black-device/MuteButton/firmware/source code/usb_hid_cdc_lib.X/README.md

# USB Hid-CDC library

Librería para implementar en un único dispositivo un HID de teclado y un puerto serie por USB
