black-device/MuteButton/firmware/source code/win-snd-mngr/btn2_green.png

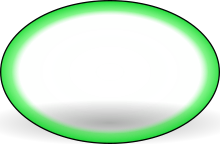
firmware/source code/win-snd-mngr/btn2_green.png
