black-device/MuteButton/firmware/source code/win-snd-mngr/btn_gray2.png

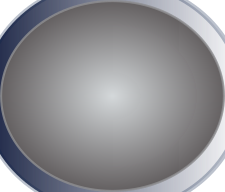
firmware/source code/win-snd-mngr/btn_gray2.png
