black-device/MuteButton/firmware/source code/win-snd-mngr/btn_gray.png

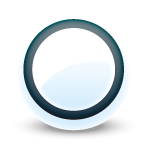
firmware/source code/win-snd-mngr/btn_gray.png
