black-device/MuteButton/images/002-mutebutton-render.jpg

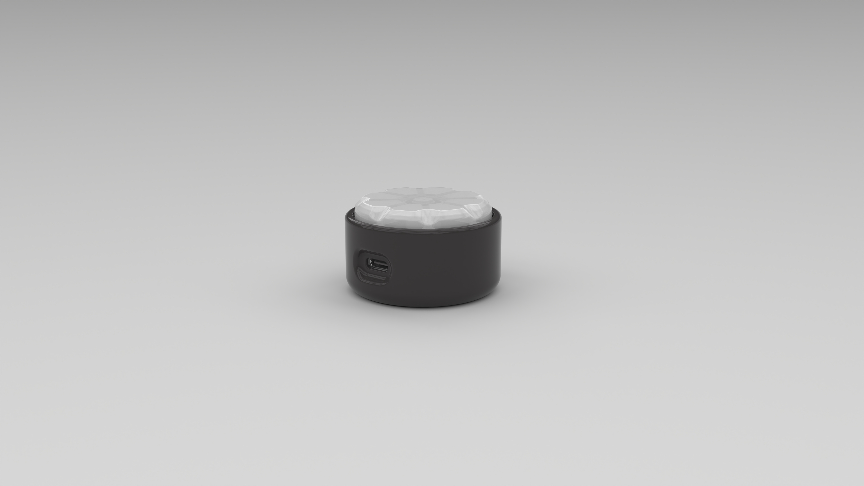
images/002-mutebutton-render.jpg
