black-device/MuteButton/images/mutebutton-exploded-specs.jpg

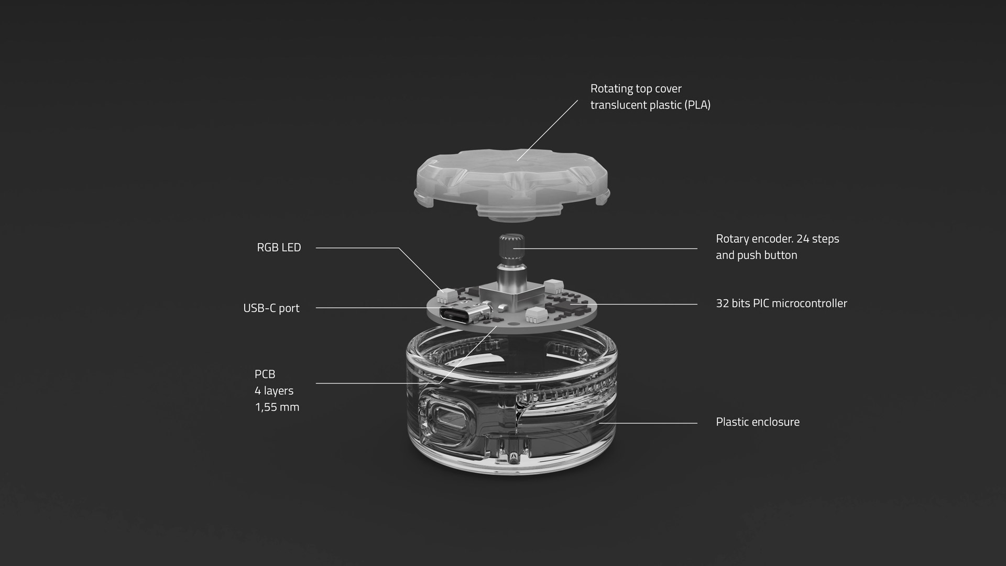
images/mutebutton-exploded-specs.jpg
