black-device/MuteButton/hardware/bom-mutebutton-v1.xlsx

Quantity | Designator | Manufacturer Part Number | Manufacturer | Comment | Description | Footprint
4 | C8, C10, C12, C13 | TMK212BBJ106MG-T | Taiyo Yuden | 10uF 25V | CAP CER 10UF 25V X5R 0805 | CAP 0805/2012 RF
3 | D1, D2, D3 | RF-W7SP30TS-A44 | REFOND | RGB RF-W7SP30TS-A44 | LED RGB PLCC6 3528 RF-W7SP30TS-A44 | LED PLCC6 3528 univ
1 | R4 | RC0603FR-0710KL | Yageo | 10K | RES SMD 10K OHM 1% 1/10W 0603 | RES 0603/1608 RF
2 | R13, R14 | RC0603FR-071KL | Yageo | 1K | RES SMD 1K OHM 1% 1/10W 0603 | RES 0603/1608 RF
1 | U1 | PIC32MM0256GPM048-I/M4 | Microchip | PIC32MM0256GPM048-I/M4 | MCU 32-Bit PIC32MMGP MIPS32 RISC 256KB Flash 2V to 3.6V 48-Pin UQFN Tube PIC32MM0256GPM048-I/M4 | UQFN48_shrink
1 | U2 | LDL1117S33R | STMicroelectronics | LDL1117S33R | IC REG LINEAR 3.3V 1.2A SOT223 | SOT223
3 | R2, R7, R9 | HP03W5F1500T5E | Royal Electronic Factory | 150R | R 0603 150R 100mW 1% HP03W5F1500T5E | RES 0603/1608 RF
1 | J2 | GSB4D313302Y1HR | Amphenol ICC / FCI | GSB4D313302Y1HR | USB4.0 GEN3, Type C, Top Mount, Ch 1.58MM, Dual Row SMT | CON_USB_C_F_GSB4D313302Y1HR
1 | SW1 | EC11E12-15P30C-SW | SR Passives | EC11E12-15P30C-SW | Encoder inc. 15 pulsos 30 paradas con switch SPST EC11E12-15P30C-SW | EC11E encoder
1 | C5 | CL10A475KO8NNNC | Samsung | 4.7uF 16V | C 0603 4.7uF 16V X5R 10% CL10A475KO8NNNC | CAP 0603/1608 RF
9 | C1, C2, C3, C4, C6, C7, C9, C11, C14 | CC0603JPX7R9BB104 | Yageo | 100nF | Cap Ceramic 0.1uF 50V X7R 5% SMD 0603 125C Paper T/R | CAP 0603/1608 RF
2 | R15, R16 | AC0603FR-075K1L | Yageo | 5K1 | R 0603 5.1K 100mW 1% AC0603FR-075K1L | RES 0603/1608 RF
3 | R3, R8, R12 | 0603SAF560JT5E | Royal Electronic Factory | 56R | R 0603 56R 100mW 1% 0603SAF560JT5E | RES 0603/1608 RF
1 | F1 | 0ZCM0010FF2G | Bel | 100mA 15V 0ZCM0010FF2G | PTC Resettable Fuse 0.1A(hold) 0.25A(trip) 15VDC 40A 0.5W 0.1s 0.9Ohm SMD Solder Pad 0603 T/R Automotive 0ZCM0010FF2G | F 0603
1 | FB1 | BLM21PG300SN1D | Murata | BLM21PG300SN1D | Ferrite Beads Multi-Layer 30Ohm 100MHz 4A 14mOhm DCR 0805 T/R BLM21PG300SN1D | FER 0805/2012
1 | RN1 | 4D03WGJ0220T | Royal Electronic Factory | 22R 5% x4 | Resistor Networks & Arrays 22R 4D03WGJ0220T | R_Array1206
3 | R1, R10, R11 | 0603SAF750JT5E | Royal Electronic Factory | 75R 1% | 0603SAF750JT5E Res Thick Film 0603 75 Ohm 1% 0.1W(1/10W) ±200ppm/°C Pad SMD T/R | RES 0603/1608 RF
