black-device/MuteButton/(threads)

Thread 1 (2025-08-30):

Add license information

vazhnov, 2025-08-30:
Hello!

I found this amazing project from https://hackaday.com/2025/08/30/silent-no-more-open-source-fix-for-mic-mishaps/

Could you please add information about the license of this repository — is it allowed to copy, change and use the code, documentation and PCB hardware files in any purpose?
It would be great to see any popular open source license.

Closed 2025-09-01.
