black-device/MuteButton/hardware/assembly-mutebutton-v1.pdf

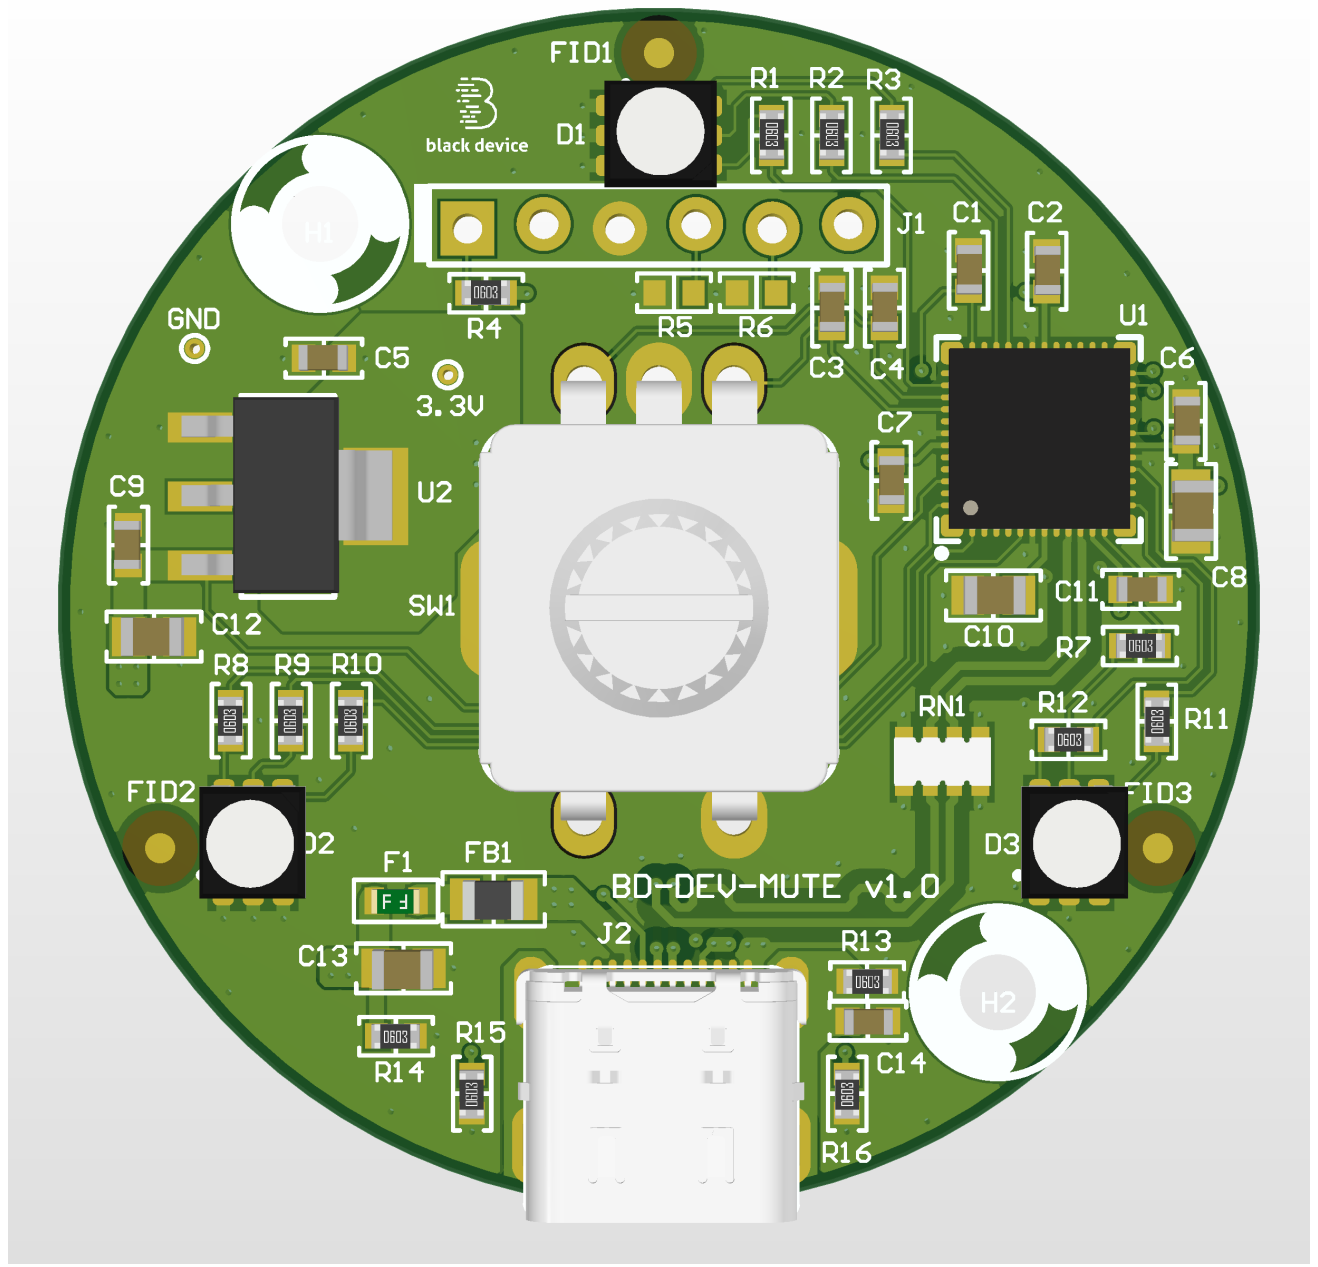
[picture p8: page 1]

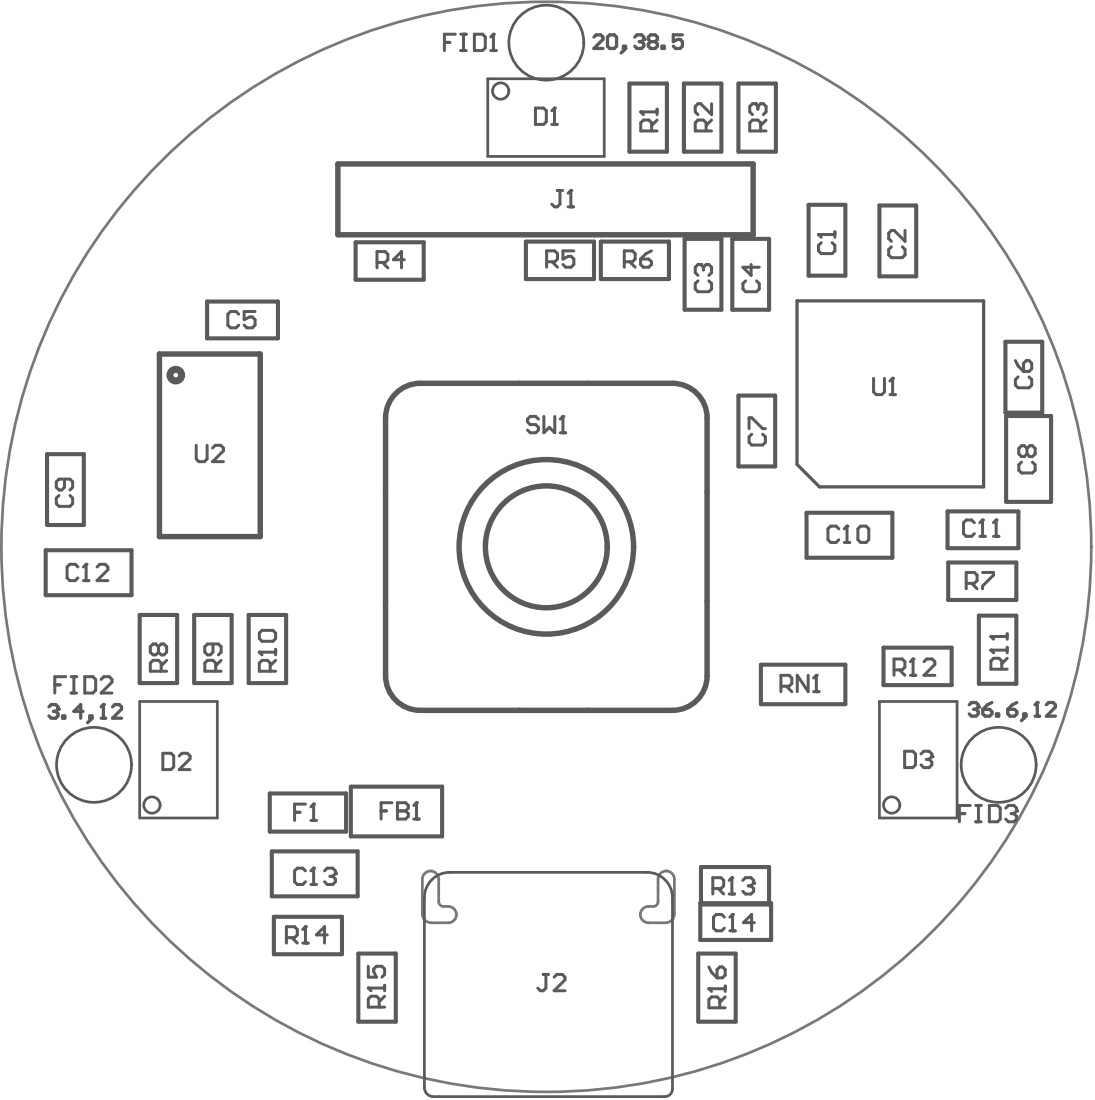
[picture p9: page 2]
